Nikhil-42/Hardware-Team-2025-2026/hub/test.jpg

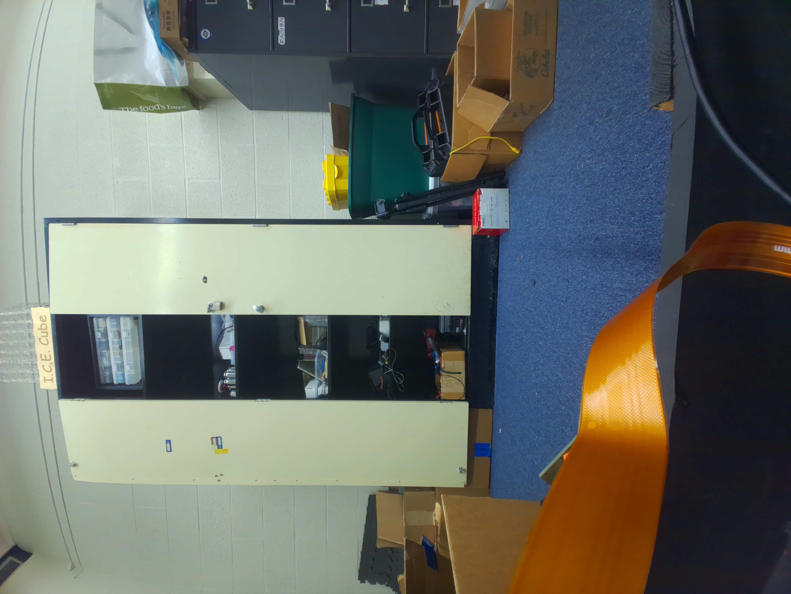
hub/test.jpg
