Nikhil-42/Hardware-Team-2025-2026/hub/src/debug_led.png

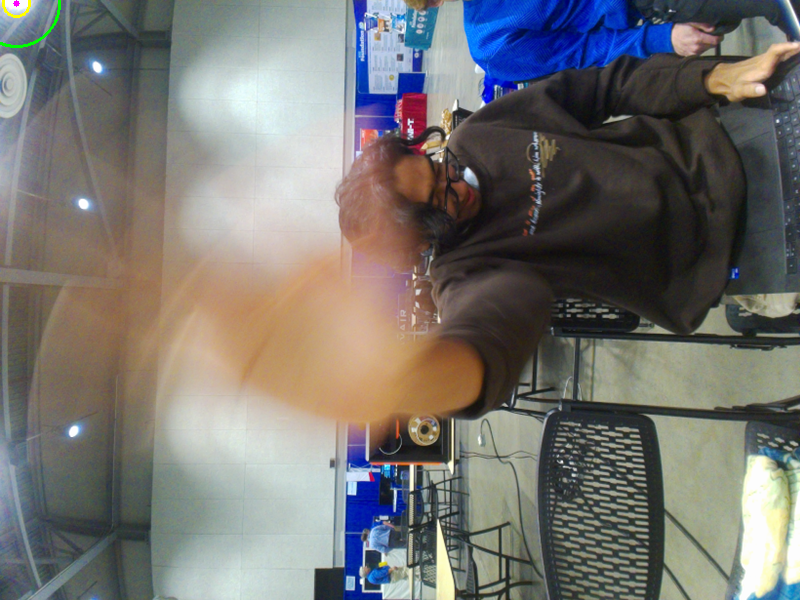
hub/src/debug_led.png
