Nikhil-42/Hardware-Team-2025-2026/README.md

# Hardware Team 2025-2026
This is the repository for the 2025-2026 IEEE Hardware Team SouthConn for UF.
