Nikhil-42/Hardware-Team-2025-2026/hub/README.md

# Hub 

Files related to the Raspberry Pi operation.

## Configuration
The Raspberry Pi is flashed with Ubuntu Server 24.04 LTS and ROS 2 Jazzy. It will automatically connect to Nikhil's hotspot. Alternatively, you can
connect via ethernet to the static IP address `10.100.100.10/28`.
