Nikhil-42/Hardware-Team-2025-2026/hub/src/hub/readme.txt

To run the bt you should *fingers crossed* only need to run the following:
	ros2 launch nav2_bringup navigation_bringup.launch.py
	ros2 run bt_navigation bt_navigator_node

Then you also need to be publishing to odom
