Nikhil-42/Hardware-Team-2025-2026/hub/ir_pos.jpg

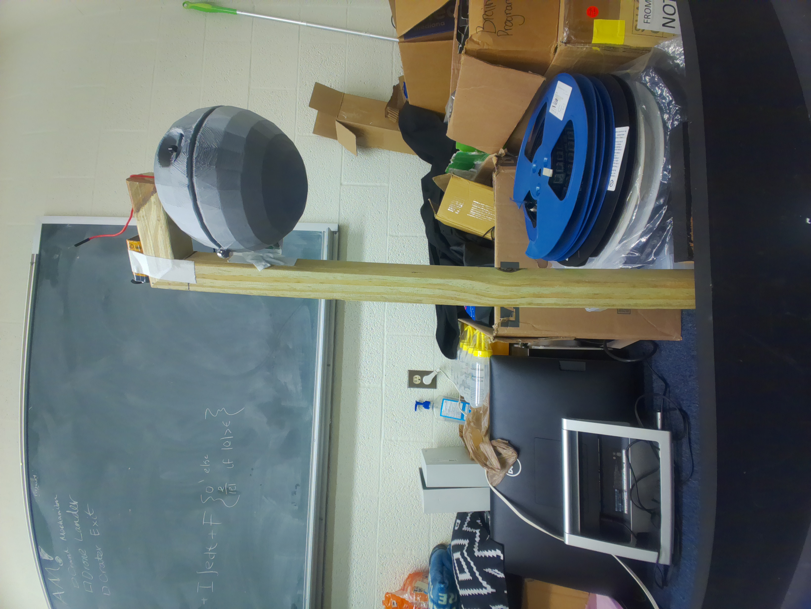
hub/ir_pos.jpg
