Nikhil-42/Hardware-Team-2025-2026/pcb/ieee.kicad_pcb

## KiCad design pcb/ieee.kicad_pcb (2026-02-16)

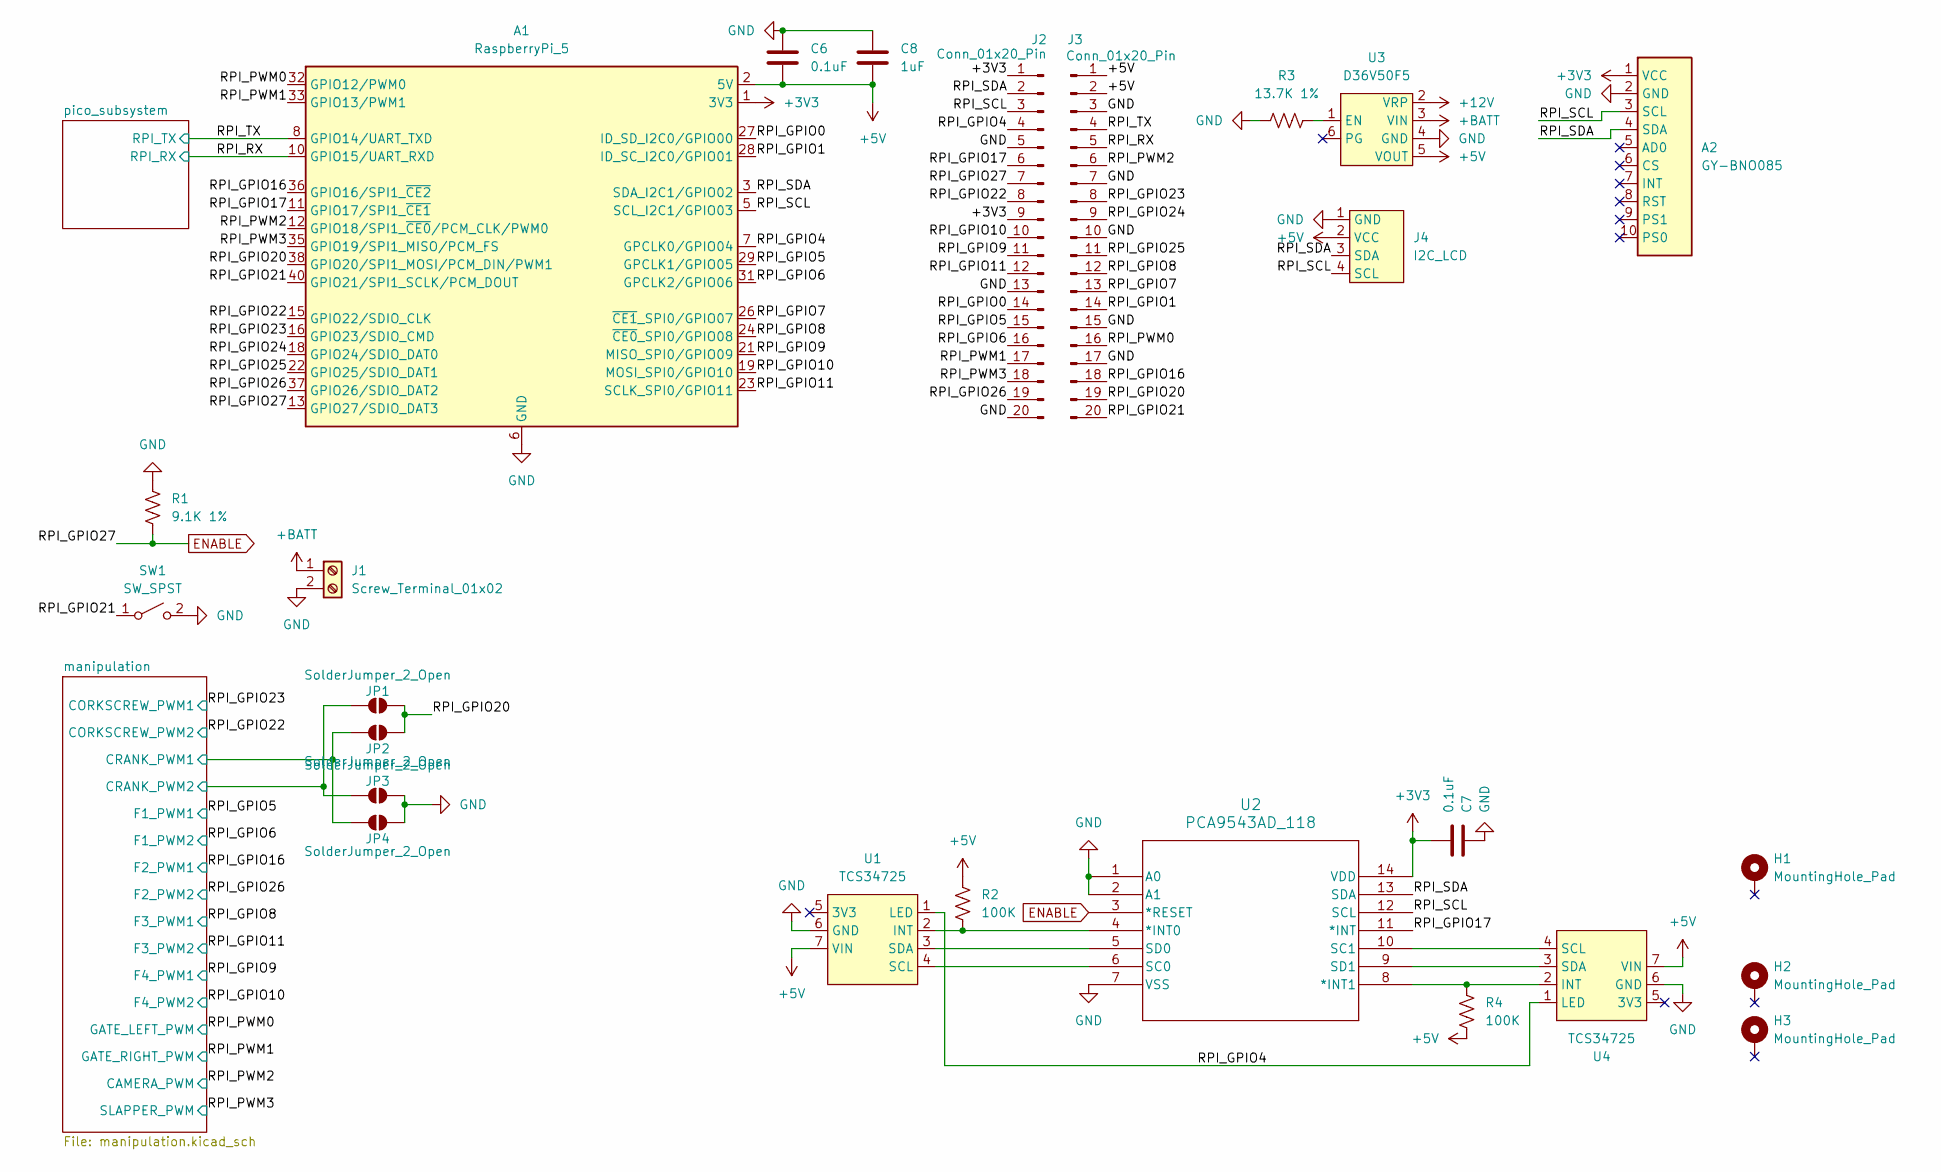
[picture p4: schematic ieee.kicad_sch]

Parts:
A1: RaspberryPi_5; Raspberry_Pi_5
A2: GY-BNO085
C6, C7: 0.1uF; C_0603_1608Metric_Pad1.08x0.95mm_HandSolder
C8: 1uF; C_0603_1608Metric_Pad1.08x0.95mm_HandSolder
H1, H2, H3: MountingHole_Pad; MountingHole_3.2mm_M3_Pad
J1: Screw_Terminal_01x02; TerminalBlock_MetzConnect_Type101_RT01602HBWC_1x02_P5.08mm_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
J2, J3: Conn_01x20_Pin; PinHeader_1x20_P2.54mm_Vertical
J4: I2C_LCD; PinHeader_1x04_P2.54mm_Vertical
JP1, JP2, JP3, JP4: SolderJumper_2_Open; SolderJumper-2_P1.3mm_Open_TrianglePad1.0x1.5mm
R1: 9.1K 1%; R_Axial_DIN0309_L9.0mm_D3.2mm_P15.24mm_Horizontal
R2, R4: 100K; R_Axial_DIN0309_L9.0mm_D3.2mm_P15.24mm_Horizontal
R3: 13.7K 1%; R_Axial_DIN0309_L9.0mm_D3.2mm_P15.24mm_Horizontal
SW1: SW_SPST; SW_PUSH_6mm
U1, U4: TCS34725; PinHeader_1x07_P2.54mm_Vertical
U2: PCA9543AD_118; SOIC-14_3.9x8.7mm_P1.27mm
U3: D36V50F5

Connections:
+3V3: A1.1 (3V3), A1.17 (3V3), A2.1 (VCC), C7.2, J2.1, J2.9, U2.14 (VDD)
+5V: A1.2 (5V), A1.4 (5V), C6.2, C8.2, J3.1, J3.2, J4.2 (VCC), R2.1, R4.2, U1.7 (VIN), U3.5 (VOUT), U4.7 (VIN); also elsewhere on the board
+12V: U3.2 (VRP)
+BATT: J1.1 (+), U3.3 (VIN); also elsewhere on the board
/RPI_GPIO0: A1.27 (ID_SD_I2C0/GPIO00), J2.14
/RPI_GPIO1: A1.28 (ID_SC_I2C0/GPIO01), J3.14
/RPI_GPIO4: A1.7 (GPCLK0/GPIO04), J2.4, U1.1 (LED), U4.1 (LED)
/RPI_GPIO5: A1.29 (GPCLK1/GPIO05), J2.15; also elsewhere on the board
/RPI_GPIO6: A1.31 (GPCLK2/GPIO06), J2.16; also elsewhere on the board
/RPI_GPIO7: A1.26 (~CE1_SPI0/GPIO07), J3.13
/RPI_GPIO8: A1.24 (~CE0_SPI0/GPIO08), J3.12; also elsewhere on the board
/RPI_GPIO9: A1.21 (MISO_SPI0/GPIO09), J2.11; also elsewhere on the board
/RPI_GPIO10: A1.19 (MOSI_SPI0/GPIO10), J2.10; also elsewhere on the board
/RPI_GPIO11: A1.23 (SCLK_SPI0/GPIO11), J2.12; also elsewhere on the board
/RPI_GPIO16: A1.36 (GPIO16/SPI1_~CE2), J3.18; also elsewhere on the board
/RPI_GPIO17: A1.11 (GPIO17/SPI1_~CE1), J2.6, U2.11 (*INT)
/RPI_GPIO20: A1.38 (GPIO20/SPI1_MOSI/PCM_DIN/PWM1), J3.19, JP1.2 (B), JP2.2 (B)
/RPI_GPIO21: A1.40 (GPIO21/SPI1_SCLK/PCM_DOUT), J3.20, SW1.1 (A)
/RPI_GPIO22: A1.15 (GPIO22/SDIO_CLK), J2.8; also elsewhere on the board
/RPI_GPIO23: A1.16 (GPIO23/SDIO_CMD), J3.8; also elsewhere on the board
/RPI_GPIO24: A1.18 (GPIO24/SDIO_DAT0), J3.9
/RPI_GPIO25: A1.22 (GPIO25/SDIO_DAT1), J3.11
/RPI_GPIO26: A1.37 (GPIO26/SDIO_DAT2), J2.19; also elsewhere on the board
/RPI_PWM0: A1.32 (GPIO12/PWM0), J3.16; also elsewhere on the board
/RPI_PWM1: A1.33 (GPIO13/PWM1), J2.17; also elsewhere on the board
/RPI_PWM2: A1.12 (GPIO18/SPI1_~CE0/PCM_CLK/PWM0), J3.6; also elsewhere on the board
/RPI_PWM3: A1.35 (GPIO19/SPI1_MISO/PCM_FS), J2.18; also elsewhere on the board
/RPI_RX: A1.10 (GPIO15/UART_RXD), J3.5; also elsewhere on the board
/RPI_SCL: A1.5 (SCL_I2C1/GPIO03), A2.3 (SCL), J2.3, J4.4 (SCL), U2.12 (SCL)
/RPI_SDA: A1.3 (SDA_I2C1/GPIO02), A2.4 (SDA), J2.2, J4.3 (SDA), U2.13 (SDA)
/RPI_TX: A1.8 (GPIO14/UART_TXD), J3.4; also elsewhere on the board
/manipulation/CRANK_PWM1: JP2.1 (A), JP4.1 (A); also elsewhere on the board
/manipulation/CRANK_PWM2: JP1.1 (A), JP3.1 (A); also elsewhere on the board
ENABLE: A1.13 (GPIO27/SDIO_DAT3), J2.7, R1.1, U2.3 (*RESET); also elsewhere on the board
GND: A1.6 (GND), A1.9 (GND), A1.14 (GND), A1.20 (GND), A1.25 (GND), A1.30 (GND), A1.34 (GND), A1.39 (GND), A2.2 (GND), C6.1, C7.1, C8.1, J1.2 (-), J2.5, J2.13, J2.20, J3.3, J3.7, J3.10, J3.15, J3.17, J4.1 (GND), JP3.2 (B), JP4.2 (B), R1.2, R3.1, SW1.2 (B), U1.6 (GND), U2.1 (A0), U2.2 (A1), U2.7 (VSS), U3.4 (GND), U4.6 (GND); also elsewhere on the board
unnamed: R2.2, U1.2 (INT), U2.4 (*INT0)
unnamed: U1.4 (SCL), U2.6 (SC0)
unnamed: U1.3 (SDA), U2.5 (SD0)
unnamed: R4.1, U2.8 (*INT1), U4.2 (INT)
unnamed: U2.10 (SC1), U4.4 (SCL)
unnamed: U2.9 (SD1), U4.3 (SDA)
unnamed: R3.2, U3.1 (EN)

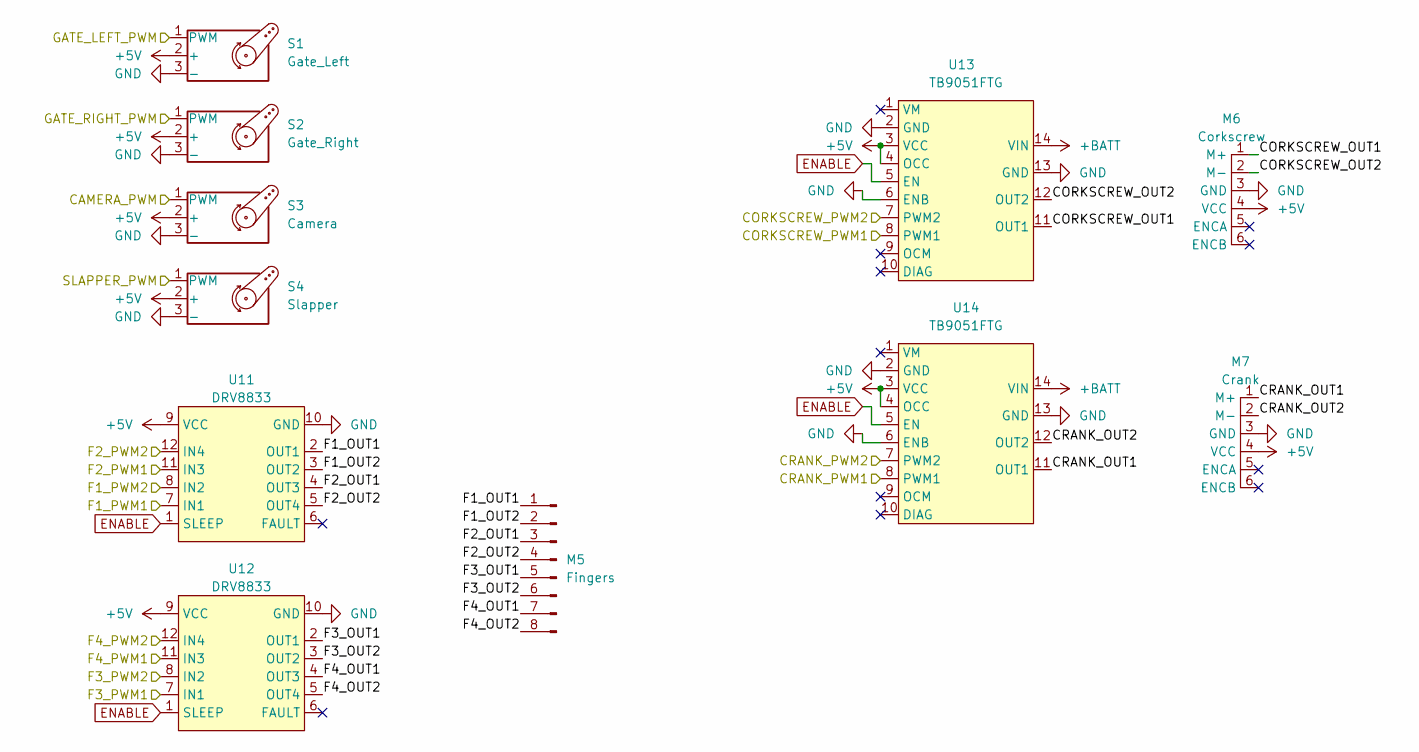
[picture p5: schematic manipulation.kicad_sch]

Parts:
M5: Fingers; PinHeader_1x08_P2.54mm_Vertical
M6: Corkscrew; PinHeader_1x06_P2.54mm_Vertical
M7: Crank; PinHeader_1x06_P2.54mm_Vertical
S1: Gate_Left; PinHeader_1x03_P2.54mm_Vertical
S2: Gate_Right; PinHeader_1x03_P2.54mm_Vertical
S3: Camera; PinHeader_1x03_P2.54mm_Vertical
S4: Slapper; PinHeader_1x03_P2.54mm_Vertical
U11, U12: DRV8833
U13, U14: TB9051FTG

Connections:
+5V: M6.4 (VCC), M7.4 (VCC), S1.2 (+), S2.2 (+), S3.2 (+), S4.2 (+), U11.9 (VCC), U12.9 (VCC), U13.3 (VCC), U13.4 (OCC), U14.3 (VCC), U14.4 (OCC); also elsewhere on the board
+BATT: U13.14 (VIN), U14.14 (VIN); also elsewhere on the board
/RPI_GPIO5: U11.7 (IN1); also elsewhere on the board
/RPI_GPIO6: U11.8 (IN2); also elsewhere on the board
/RPI_GPIO8: U12.7 (IN1); also elsewhere on the board
/RPI_GPIO9: U12.11 (IN3); also elsewhere on the board
/RPI_GPIO10: U12.12 (IN4); also elsewhere on the board
/RPI_GPIO11: U12.8 (IN2); also elsewhere on the board
/RPI_GPIO16: U11.11 (IN3); also elsewhere on the board
/RPI_GPIO22: U13.7 (PWM2); also elsewhere on the board
/RPI_GPIO23: U13.8 (PWM1); also elsewhere on the board
/RPI_GPIO26: U11.12 (IN4); also elsewhere on the board
/RPI_PWM0: S1.1 (PWM); also elsewhere on the board
/RPI_PWM1: S2.1 (PWM); also elsewhere on the board
/RPI_PWM2: S3.1 (PWM); also elsewhere on the board
/RPI_PWM3: S4.1 (PWM); also elsewhere on the board
/manipulation/CORKSCREW_OUT1: M6.1 (M+), U13.11 (OUT1)
/manipulation/CORKSCREW_OUT2: M6.2 (M-), U13.12 (OUT2)
/manipulation/CRANK_OUT1: M7.1 (M+), U14.11 (OUT1)
/manipulation/CRANK_OUT2: M7.2 (M-), U14.12 (OUT2)
/manipulation/CRANK_PWM1: U14.8 (PWM1); also elsewhere on the board
/manipulation/CRANK_PWM2: U14.7 (PWM2); also elsewhere on the board
/manipulation/F1_OUT1: M5.1, U11.2 (OUT1)
/manipulation/F1_OUT2: M5.2, U11.3 (OUT2)
/manipulation/F2_OUT1: M5.3, U11.4 (OUT3)
/manipulation/F2_OUT2: M5.4, U11.5 (OUT4)
/manipulation/F3_OUT1: M5.5, U12.2 (OUT1)
/manipulation/F3_OUT2: M5.6, U12.3 (OUT2)
/manipulation/F4_OUT1: M5.7, U12.4 (OUT3)
/manipulation/F4_OUT2: M5.8, U12.5 (OUT4)
ENABLE: U11.1 (SLEEP), U12.1 (SLEEP), U13.5 (EN), U14.5 (EN); also elsewhere on the board
GND: M6.3 (GND), M7.3 (GND), S1.3 (-), S2.3 (-), S3.3 (-), S4.3 (-), U11.10 (GND), U12.10 (GND), U13.2 (GND), U13.6 (ENB), U13.13 (GND), U14.2 (GND), U14.6 (ENB), U14.13 (GND); also elsewhere on the board

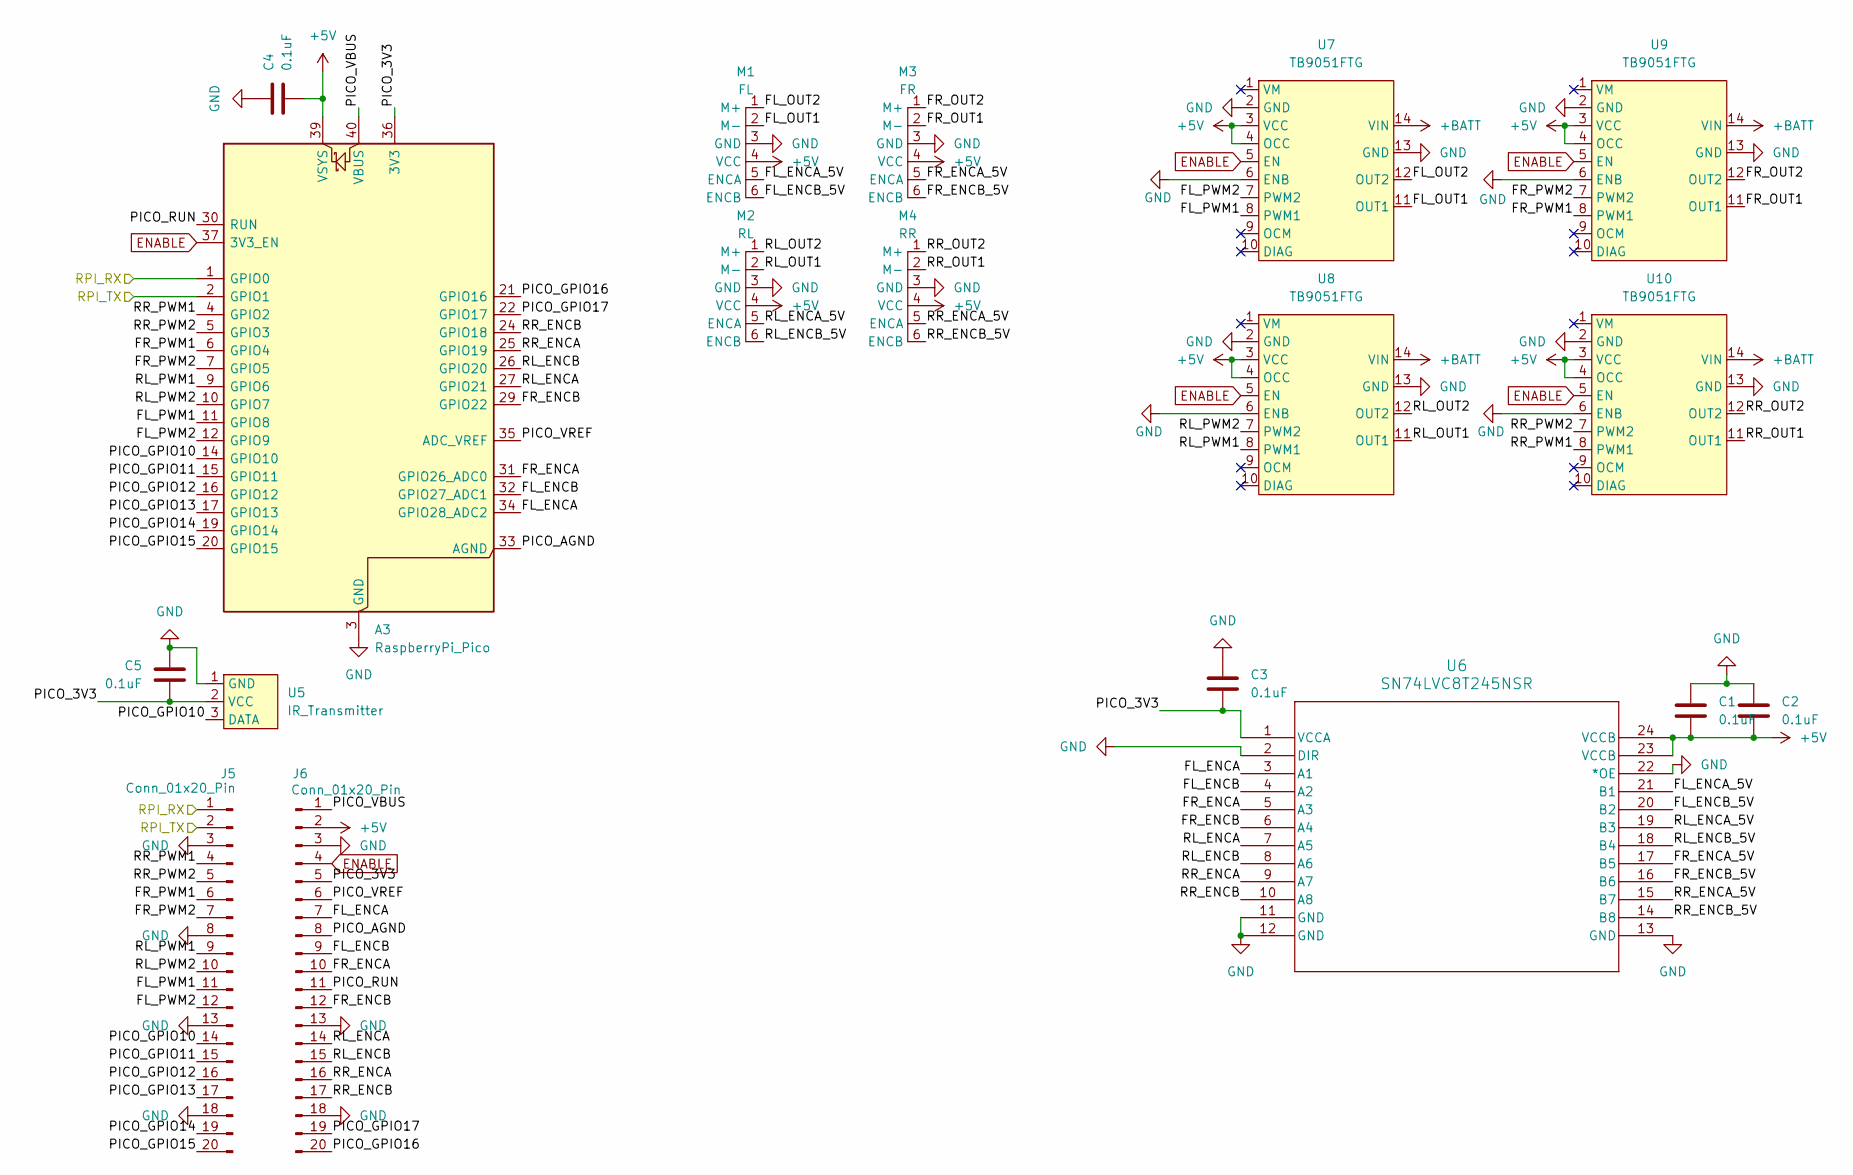
[picture p6: schematic pico.kicad_sch]

Parts:
A3: RaspberryPi_Pico; RaspberryPi_Pico_Common_Unspecified
C1, C2, C3, C4, C5: 0.1uF; C_0603_1608Metric_Pad1.08x0.95mm_HandSolder
J5, J6: Conn_01x20_Pin; PinHeader_1x20_P2.54mm_Vertical
M1: FL; PinHeader_1x06_P2.54mm_Vertical
M2: RL; PinHeader_1x06_P2.54mm_Vertical
M3: FR; PinHeader_1x06_P2.54mm_Vertical
M4: RR; PinHeader_1x06_P2.54mm_Vertical
U5: IR_Transmitter; PinHeader_1x03_P2.54mm_Vertical
U6: SN74LVC8T245NSR; NS24
U7, U8, U9, U10: TB9051FTG

Connections:
+5V: A3.39 (VSYS), C1.2, C2.2, C4.2, J6.2, M1.4 (VCC), M2.4 (VCC), M3.4 (VCC), M4.4 (VCC), U6.23 (VCCB), U6.24 (VCCB), U7.3 (VCC), U7.4 (OCC), U8.3 (VCC), U8.4 (OCC), U9.3 (VCC), U9.4 (OCC), U10.3 (VCC), U10.4 (OCC); also elsewhere on the board
+BATT: U7.14 (VIN), U8.14 (VIN), U9.14 (VIN), U10.14 (VIN); also elsewhere on the board
/RPI_RX: A3.1 (GPIO0), J5.1; also elsewhere on the board
/RPI_TX: A3.2 (GPIO1), J5.2; also elsewhere on the board
/pico_subsystem/FL_ENCA: A3.34 (GPIO28_ADC2), J6.7, U6.3 (A1)
/pico_subsystem/FL_ENCA_5V: M1.5 (ENCA), U6.21 (B1)
/pico_subsystem/FL_ENCB: A3.32 (GPIO27_ADC1), J6.9, U6.4 (A2)
/pico_subsystem/FL_ENCB_5V: M1.6 (ENCB), U6.20 (B2)
/pico_subsystem/FL_OUT1: M1.2 (M-), U7.11 (OUT1)
/pico_subsystem/FL_OUT2: M1.1 (M+), U7.12 (OUT2)
/pico_subsystem/FL_PWM1: A3.11 (GPIO8), J5.11, U7.8 (PWM1)
/pico_subsystem/FL_PWM2: A3.12 (GPIO9), J5.12, U7.7 (PWM2)
/pico_subsystem/FR_ENCA: A3.31 (GPIO26_ADC0), J6.10, U6.5 (A3)
/pico_subsystem/FR_ENCA_5V: M3.5 (ENCA), U6.17 (B5)
/pico_subsystem/FR_ENCB: A3.29 (GPIO22), J6.12, U6.6 (A4)
/pico_subsystem/FR_ENCB_5V: M3.6 (ENCB), U6.16 (B6)
/pico_subsystem/FR_OUT1: M3.2 (M-), U9.11 (OUT1)
/pico_subsystem/FR_OUT2: M3.1 (M+), U9.12 (OUT2)
/pico_subsystem/FR_PWM1: A3.6 (GPIO4), J5.6, U9.8 (PWM1)
/pico_subsystem/FR_PWM2: A3.7 (GPIO5), J5.7, U9.7 (PWM2)
/pico_subsystem/PICO_3V3: A3.36 (3V3), C3.2, C5.2, J6.5, U5.2 (VCC), U6.1 (VCCA)
/pico_subsystem/PICO_AGND: A3.33 (AGND), J6.8
/pico_subsystem/PICO_GPIO10: A3.14 (GPIO10), J5.14, U5.3 (DATA)
/pico_subsystem/PICO_GPIO11: A3.15 (GPIO11), J5.15
/pico_subsystem/PICO_GPIO12: A3.16 (GPIO12), J5.16
/pico_subsystem/PICO_GPIO13: A3.17 (GPIO13), J5.17
/pico_subsystem/PICO_GPIO14: A3.19 (GPIO14), J5.19
/pico_subsystem/PICO_GPIO15: A3.20 (GPIO15), J5.20
/pico_subsystem/PICO_GPIO16: A3.21 (GPIO16), J6.20
/pico_subsystem/PICO_GPIO17: A3.22 (GPIO17), J6.19
/pico_subsystem/PICO_RUN: A3.30 (RUN), J6.11
/pico_subsystem/PICO_VBUS: A3.40 (VBUS), J6.1
/pico_subsystem/PICO_VREF: A3.35 (ADC_VREF), J6.6
/pico_subsystem/RL_ENCA: A3.27 (GPIO21), J6.14, U6.7 (A5)
/pico_subsystem/RL_ENCA_5V: M2.5 (ENCA), U6.19 (B3)
/pico_subsystem/RL_ENCB: A3.26 (GPIO20), J6.15, U6.8 (A6)
/pico_subsystem/RL_ENCB_5V: M2.6 (ENCB), U6.18 (B4)
/pico_subsystem/RL_OUT1: M2.2 (M-), U8.11 (OUT1)
/pico_subsystem/RL_OUT2: M2.1 (M+), U8.12 (OUT2)
/pico_subsystem/RL_PWM1: A3.9 (GPIO6), J5.9, U8.8 (PWM1)
/pico_subsystem/RL_PWM2: A3.10 (GPIO7), J5.10, U8.7 (PWM2)
/pico_subsystem/RR_ENCA: A3.25 (GPIO19), J6.16, U6.9 (A7)
/pico_subsystem/RR_ENCA_5V: M4.5 (ENCA), U6.15 (B7)
/pico_subsystem/RR_ENCB: A3.24 (GPIO18), J6.17, U6.10 (A8)
/pico_subsystem/RR_ENCB_5V: M4.6 (ENCB), U6.14 (B8)
/pico_subsystem/RR_OUT1: M4.2 (M-), U10.11 (OUT1)
/pico_subsystem/RR_OUT2: M4.1 (M+), U10.12 (OUT2)
/pico_subsystem/RR_PWM1: A3.4 (GPIO2), J5.4, U10.8 (PWM1)
/pico_subsystem/RR_PWM2: A3.5 (GPIO3), J5.5, U10.7 (PWM2)
ENABLE: A3.37 (3V3_EN), J6.4, U7.5 (EN), U8.5 (EN), U9.5 (EN), U10.5 (EN); also elsewhere on the board
GND: A3.3 (GND), A3.8 (GND), A3.13 (GND), A3.18 (GND), A3.23 (GND), A3.28 (GND), A3.38 (GND), C1.1, C2.1, C3.1, C4.1, C5.1, J5.3, J5.8, J5.13, J5.18, J6.3, J6.13, J6.18, M1.3 (GND), M2.3 (GND), M3.3 (GND), M4.3 (GND), U5.1 (GND), U6.2 (DIR), U6.11 (GND), U6.12 (GND), U6.13 (GND), U6.22 (*OE), U7.2 (GND), U7.6 (ENB), U7.13 (GND), U8.2 (GND), U8.6 (ENB), U8.13 (GND), U9.2 (GND), U9.6 (ENB), U9.13 (GND), U10.2 (GND), U10.6 (ENB), U10.13 (GND); also elsewhere on the board

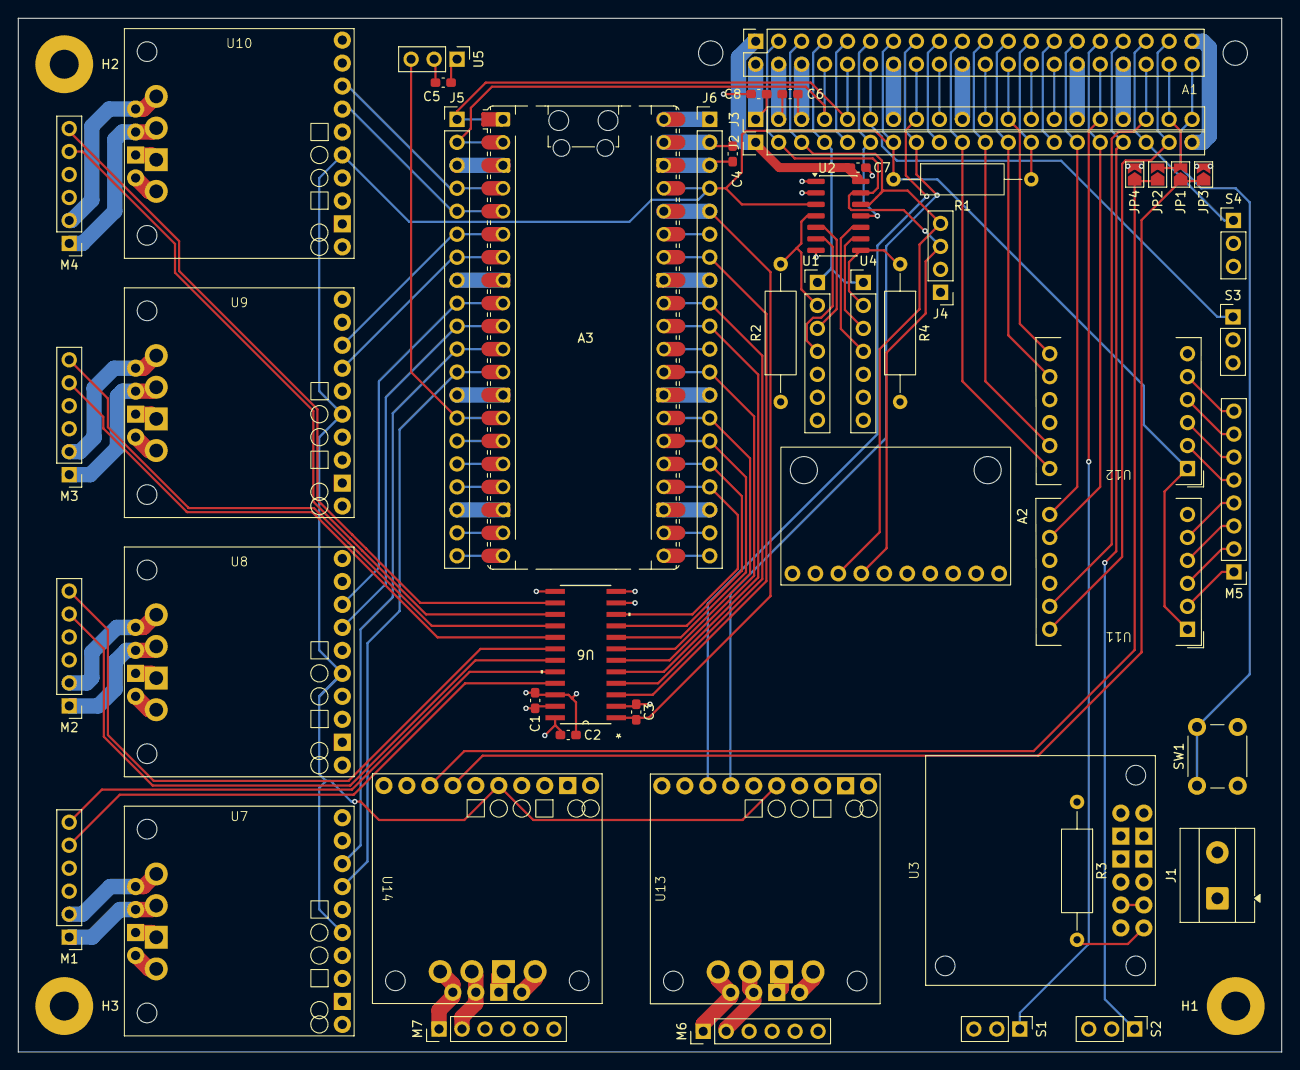
[picture p7: board ieee.kicad_pcb from above]

Board: 4 copper layers, 139.7 x 114.3 mm, 54 parts (0 on the bottom side), 98 nets.
