Nikhil-42/Hardware-Team-2025-2026/hub/src/behaviors/src/bt_executor.cpp

// Copyright 2024 Marq Rasmussen
//
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
#include <iostream>
#include <fstream>
#include <rclcpp/rclcpp.hpp>
#include <rclcpp/executors.hpp>
#include <behaviortree_ros2/tree_execution_server.hpp>
#include <behaviortree_cpp/bt_factory.h>
#include <behaviortree_cpp/xml_parsing.h>
#include <behaviortree_cpp/loggers/bt_cout_logger.h>
#include <std_msgs/msg/float32.hpp>

#include "behaviors/finger_node.hpp"
#include "behaviors/drive_to_pose_node.hpp"
#include "behaviors/report_color_node.hpp"
#include "behaviors/start_node.hpp"
#include "behaviors/get_color_node.hpp"
#include "behaviors/gate_node.hpp"
#include "behaviors/map_correction_node.hpp"
#include "behaviors/motor_node.hpp"

// Example that shows how to customize TreeExecutionServer.
//
// Here, we:
// - add an extra logger, BT::StdCoutLogger
// - add a subscriber that will continuously update a variable in the global blackboard

class MyActionServer : public BT::TreeExecutionServer
{
public:
  MyActionServer(const rclcpp::NodeOptions& options) : TreeExecutionServer(options)
  {
    // here we assume that the battery voltage is published as a std_msgs::msg::Float32
    sub_ = node()->create_subscription<std_msgs::msg::Float32>(
        "battery_level", 10, [this](const std_msgs::msg::Float32::SharedPtr msg) {
          // Update the global blackboard
          globalBlackboard()->set("battery_level", msg->data);
        });
    // Note that the callback above and the execution of the tree accessing the
    // global blackboard happen in two different threads.
    // The former runs in the MultiThreadedExecutor, while the latter in the thread created
    // by TreeExecutionServer. But this is OK because the blackboard is thread-safe.
  }

  virtual void registerNodesIntoFactory(BT::BehaviorTreeFactory& factory)
  {
    // Create the RosNodeParams the BT ROS2 nodes need
    BT::RosNodeParams drive_to_pose_params;
    drive_to_pose_params.nh = node();                 // the rclcpp::Node::SharedPtr
    drive_to_pose_params.server_timeout = std::chrono::seconds(60);
    factory.registerNodeType<DriveToPoseNode>("DriveToPose", drive_to_pose_params);

    BT::RosNodeParams finger_params;
    finger_params.nh = node();                 // the rclcpp::Node::SharedPtr
    finger_params.server_timeout = std::chrono::seconds(10);
    factory.registerNodeType<FingerNode>("Finger", finger_params);

    BT::RosNodeParams start_params;
    start_params.nh = node();                 // the rclcpp::Node::SharedPtr
    factory.registerNodeType<StartNode>("Start", start_params);

    BT::RosNodeParams report_color_params;
    report_color_params.nh = node();                 // the rclcpp::Node::SharedPtr
    report_color_params.server_timeout = std::chrono::seconds(10);
    factory.registerNodeType<ReportColorNode>("ReportColor", report_color_params);

    BT::RosNodeParams get_color_params;
    get_color_params.nh = node();
    get_color_params.server_timeout = std::chrono::seconds(10);
    factory.registerNodeType<GetColorNode>("GetColor", get_color_params);

    BT::RosNodeParams gate_params;
    gate_params.nh = node();
    gate_params.server_timeout = std::chrono::seconds(10);
    factory.registerNodeType<GateNode>("Gate", gate_params);

    BT::RosNodeParams map_correction_params;
    map_correction_params.nh = node();
    map_correction_params.server_timeout = std::chrono::seconds(10);
    factory.registerNodeType<MapCorrectionNode>("MapCorrection", map_correction_params);

    BT::RosNodeParams motor_params;
    motor_params.nh = node();
    motor_params.server_timeout = std::chrono::seconds(10);
    factory.registerNodeType<MotorNode>("Motor", motor_params);

    std::string xml_models = BT::writeTreeNodesModelXML(factory);
    // RCLCPP_INFO(rclcpp::get_logger(), "Registered the following nodes into the factory:\n%s", xml_models.c_str());

    // Save to file
    auto xml_file = std::ofstream("/home/ieee/tree_nodes_model.xml");
    if(xml_file.is_open())
    {
      xml_file << xml_models;
      xml_file.close();
    }
  }

  void onTreeCreated(BT::Tree& tree) override
  {
    logger_cout_ = std::make_shared<BT::StdCoutLogger>(tree);
  }

  std::optional<std::string> onTreeExecutionCompleted(BT::NodeStatus status,
                                                      bool was_cancelled) override
  {
    // NOT really needed, even if logger_cout_ may contain a dangling pointer of the tree
    // at this point
    logger_cout_.reset();
    return std::nullopt;
  }

private:
  std::shared_ptr<BT::StdCoutLogger> logger_cout_;
  rclcpp::Subscription<std_msgs::msg::Float32>::SharedPtr sub_;
};

int main(int argc, char* argv[])
{
  rclcpp::init(argc, argv);

  rclcpp::NodeOptions options;
  auto action_server = std::make_shared<MyActionServer>(options);

  // TODO: This workaround is for a bug in MultiThreadedExecutor where it can deadlock when spinning without a timeout.
  // Deadlock is caused when Publishers or Subscribers are dynamically removed as the node is spinning.
  rclcpp::executors::MultiThreadedExecutor exec(rclcpp::ExecutorOptions(), 0, false,
                                                std::chrono::milliseconds(250));
  exec.add_node(action_server->node());
  exec.spin();
  exec.remove_node(action_server->node());

  rclcpp::shutdown();
}
