Nikhil-42/Hardware-Team-2025-2026/pico-code/include/pinout.h

#pragma once
#include <stdint.h>

// transciever pins whenever that code is migrated here
#define IR_TRANSMIT_PIN 10

// ----------------------------------- MOTOR PINMAPPING -----------------------------------------------
#define WHEEL_COUNT 4
#define MAX_GPIO 29 // 0 - 28
enum WheelPosition {FL, FR, RL, RR};
// marks wheels that are inverted
extern int8_t inverter[WHEEL_COUNT];

typedef struct MotorChannel
{
        uint8_t encoderA;
        uint8_t encoderB;
        uint8_t pwm1;
        uint8_t pwm2; 
} MotorChannel;  

// Stores the GPIO pins corresponding to each motor channel 
extern const MotorChannel motorPinMap [WHEEL_COUNT];
