Nikhil-42/Hardware-Team-2025-2026/pico-code/include/uart.h

#pragma once
#include <stdint.h>
#include <stdbool.h>
#include "kinematics.h"
#include "odom.h"

#define UART0_BAUD 115200
#define UART0_DATA 8
#define UART0_STOP 1
#define UART1_BAUD 115200
#define UART1_DATA 8
#define UART1_STOP 1
#define SPEED_DATA_VALUES_COUNT 3
#define POSITION_DATA_VALUES_COUNT 3
#define BYTES_PER_DATA_VALUE 4
#define TOTAL_SPEED_DATA_BYTES (SPEED_DATA_VALUES_COUNT * BYTES_PER_DATA_VALUE)
#define TOTAL_POSITION_DATA_BYTES (POSITION_DATA_VALUES_COUNT * BYTES_PER_DATA_VALUE)
#define BYTES_IN_SPEED_TRANSMISSION (TOTAL_SPEED_DATA_BYTES + 4) // for two start and two end byte 
#define BYTES_IN_SENT_PACKET (TOTAL_SPEED_DATA_BYTES + TOTAL_POSITION_DATA_BYTES + 4 + 1) 

#define SPEED_START_BYTE_H 0xFF
#define SPEED_START_BYTE_L 0xFF
#define SPEED_END_BYTE_H 0xEE
#define SPEED_END_BYTE_L 0xEE
#define ANTENNA_START_BYTE_H 0x11
#define ANTENNA_START_BYTE_L 0x11
#define ANTENNA_END_BYTE_H 0xDD
#define ANTENNA_END_BYTE_L 0xDD

// stores flag to indicate UART receptions
extern bool cmd_ready;
extern bool ant_code_ready;
extern bool transmission_ready; 
extern robot_velocities_t cmd_vel;
extern uint8_t rx_ant_code;

/*
        initialize the uart module with the appropriate frame settings and baud rate
*/
void uart0_init();

/*
        initialize the uart module with the appropriate frame settings and baud rate
*/
void uart1_init();

/*
        given robot velocities and pose, 
*/
void send_speed_packet(robot_velocities_t* robo_v, pose_t* pose);

/*
        given an antenna and color code
*/
