Nikhil-42/Hardware-Team-2025-2026/hub/src/behaviors/src/plugin.cpp

#include "behaviortree_ros2/plugins.hpp"

#include "behaviors/drive_to_pose_node.hpp"
#include "behaviors/finger_node.hpp"
#include "behaviors/report_color_node.hpp"
#include "behaviors/start_node.hpp"

using namespace BT;

extern "C" void BT_RegisterRosNodeFromPlugin(
  BehaviorTreeFactory& factory,
  const RosNodeParams& params)
{
  // This is the part that depends on your BT ROS2 wrapper version.
  // In many setups, this works:
  factory.registerNodeType<DriveToPoseNode>("DriveToPose", params);
  factory.registerNodeType<FingerNode>("Finger", params);
  factory.registerNodeType<ReportColorNode>("ReportColor", params);
  factory.registerNodeType<StartNode>("Start", params);

  // If the above doesn't compile, the wrapper might provide a helper instead.
  // In that case, tell me what compile error you get and I’ll adapt it.
}
