Nikhil-42/Hardware-Team-2025-2026/(commit log)

2026-01-13 motor control and transmitter code
    Code for motor control and IR transmitter
2026-01-15 most recent code
    need to finish odom and update uart communication
2026-01-22 updated code
    updated and working code for motor control. For fixed sampling, calculated distance between ticks of encoder channels instead of cumulative counts which improved RPM calculations significantly.
    [encoder.c, encoder.h, keyboard.c, kinematics.c, kinematics.h, motor-control.c, motor.c, odom.c]
2026-02-03 Updates to pico code
2026-02-06 Add bno085-ros2-driver
2026-02-06 Add support for fingers via finger service
2026-02-06 measurement updates
    updated robot geometry measurements for kinematics and odom
2026-02-12 Create PCB
    [ieee.kicad_pcb, ieee.kicad_sch, manipulation.kicad_sch, pico.kicad_sch]
2026-02-13 Fix ERC issues and layout connectors
    [ieee.kicad_pcb, ieee.kicad_sch, manipulation.kicad_sch, pico.kicad_sch]
2026-02-13 Save after closing KiCAD
2026-02-13 Start routing
    [ieee.kicad_pcb, pico.kicad_sch]
2026-02-13 Remove edge cuts from IMU
2026-02-15 Route RPI and Pico breakouts
    [ieee.kicad_pcb]
2026-02-15 Route I2C and planes
    [ieee.kicad_pcb, ieee.kicad_sch, manipulation.kicad_sch, pico.kicad_sch]
2026-02-16 Finish layout
    [ieee-B_Cu.gbr, ieee-B_Mask.gbr, ieee-B_Paste.gbr, ieee-B_Silkscreen.gbr, ieee-Edge_Cuts.gbr, ieee-F_Cu.gbr, ieee-F_Mask.gbr, ieee-F_Paste.gbr]
2026-02-16 Fix after design review
    [ieee.kicad_pcb, ieee.kicad_sch, pico.kicad_sch]
2026-02-16 Fab outputs
    [ieee-B_Cu.gbr, ieee-B_Mask.gbr, ieee-B_Paste.gbr, ieee-B_Silkscreen.gbr, ieee-Edge_Cuts.gbr, ieee-F_Cu.gbr, ieee-F_Mask.gbr, ieee-F_Paste.gbr]
2026-02-17 Add camera_ros as submodule
2026-02-19 Create robot_bringup launch file
    [robot.urdf.xacro]
2026-02-21 Added action server and PID controller. Need to write action client to complete DriveToPose
2026-02-26 changes to robot geometry and encoder difference calculation
2026-02-27 added xor checksum to remove possible corrupted frames and some failed turtlesim action attempts
2026-02-27 latest camera and drive to pose changes
2026-02-27 updated PID controller with additional control logic and transformed errors from odom to baselink frame
2026-02-28 Create behaviors package from sample
2026-02-28 Keyboard and button full auto
2026-03-04 updated pico code
2026-03-04 Repeat NEC send pico
2026-03-04 Switch to PIO based NEC (from Adafruit)
2026-03-10 Update Pico code for PCB layout
2026-03-14 updated pico pinout and attempted fixes for motor control
2026-03-14 map->base_link transformation, imu in ekf, covariances added. Need to build in this branch on Pi to resolve remaining errors
    [bno08x_ros.cpp, bt_executor.cpp, map_correction_node.cpp]
2026-03-14 Add the motor control nodes
2026-03-14 Fix motor action server
2026-03-14 enable picoboot via uart
2026-03-14 Button autonomous completed
